AlexanderChad/STM32H743VI_Countdown/Core/Src/main.c

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
/* Includes ------------------------------------------------------------------*/
#include "main.h"

/* USER CODE BEGIN Includes */
#include <stdio.h>
#include <string.h>
#include <time.h>
/* USER CODE END Includes */

/* USER CODE BEGIN PD */
struct tm EventDate;
struct tm NowTime;
int utc_timezone = 7;

#define FONT0_LENGTH            11
#define FONT0_START_CHAR        48
#define FONT0_CHAR_WIDTH        8
#define FONT0_CHAR_HEIGHT       14
#define FONT0_FONT_TYPE         (FONT_TYPE_MONOSPACED)
#define FONT0_ARRAY_LENGTH      (FONT0_LENGTH * FONT0_CHAR_WIDTH)

const unsigned long  font0[FONT0_ARRAY_LENGTH] =
{

        // Digits / Цифры
    0b00000000000000000000011111111000, 0b00000000000000000001111111111110, 0b00000000000000000011100000000111, 0b00000000000000000011000000000011, 0b00000000000000000011100000000111, 0b00000000000000000001111111111110, 0b00000000000000000000011111111000, 0b00000000000000000000000000000000, // Символ 48  <0>
    0b00000000000000000011000000001100, 0b00000000000000000011000000001110, 0b00000000000000000011000000000111, 0b00000000000000000011111111111111, 0b00000000000000000011111111111111, 0b00000000000000000011111111111111, 0b00000000000000000011000000000000, 0b00000000000000000011000000000000, // Символ 49  <1>
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
#define Rx1Buf_SIZE 100 //размер ожидаемой части для добавления в кольцевой буфер

/* USER CODE END PD */


TIM_HandleTypeDef htim1;
TIM_HandleTypeDef htim2;

UART_HandleTypeDef huart1;
UART_HandleTypeDef huart3;
DMA_HandleTypeDef hdma_usart1_rx;

void SystemClock_Config(void);
static void MX_GPIO_Init(void);
static void MX_TIM1_Init(void);
static void MX_USART3_UART_Init(void);
static void MX_DMA_Init(void);
static void MX_USART1_UART_Init(void);
static void MX_TIM2_Init(void);
/* USER CODE BEGIN 0 */

uint16_t TOnLP = 33;
uint16_t Dl_CLK = 5;

uint8_t RAW_DISPLAY[20][32];
uint8_t ColorMatrix = 0;
const uint8_t ColorMatrix0 = 4;
uint8_t ColorMatrix1 = 7;
int SetColorMatrix = 7;

void delay_clk(uint16_t clk) //create delay function
{
	for (uint16_t j = 0; j < clk; j++)
		asm("NOP");
	//Perform no operation //assembly code
}

void delay_us(uint16_t us) //create delay function
{
	for (uint16_t i = 0; i < us; i++) {
		for (uint16_t j = 0; j < 480; j++)
			asm("NOP");
		//Perform no operation //assembly code
	}
}

void SaveSettings() {
	int bp[8] = { utc_timezone, EventDate.tm_sec, EventDate.tm_min,
			EventDate.tm_hour, EventDate.tm_mday, EventDate.tm_mon,
			EventDate.tm_year, SetColorMatrix };
	HAL_FLASH_Unlock();
	FLASH_Erase_Sector(FLASH_SECTOR_7, FLASH_BANK_2, VOLTAGE_RANGE_1);
	HAL_FLASH_Program(FLASH_TYPEPROGRAM_FLASHWORD, SETTINGS_ADDRESS, &bp);
	HAL_FLASH_Lock();
}

void RestoreSettings() {
	int RSetting[8] = { 0 };
	memcpy(RSetting, SETTINGS_ADDRESS, 32);
	utc_timezone = RSetting[0];
	EventDate.tm_sec = RSetting[1];
	EventDate.tm_min = RSetting[2];
	EventDate.tm_hour = RSetting[3];
	EventDate.tm_mday = RSetting[4];
	EventDate.tm_mon = RSetting[5];
	EventDate.tm_year = RSetting[6];
	SetColorMatrix = RSetting[7];
	if (SetColorMatrix) {
		ColorMatrix1 = SetColorMatrix;
	}
}

void SetPixel(uint8_t Xp, uint8_t Yp, uint8_t N_p, uint16_t ON) {
	uint8_t n_byte = 0;
	uint8_t bit_mask;
	if (Yp >= 8) {
		Yp -= 8;
		n_byte = 16;
	}
	if (Yp < 4) {
		if (Xp < 8) {
			n_byte += (Yp % 4) * 4;
		} else {
			n_byte += 2 + (Yp % 4) * 4;
		}
		bit_mask = 128 >> (Xp % 8);
	} else {
		if (Xp < 8) {
			n_byte += 1 + (Yp % 4) * 4;
		} else {
			n_byte += 3 + (Yp % 4) * 4;
		}
		bit_mask = 1 << (Xp % 8);
	}
	uint8_t SP = RAW_DISPLAY[N_p][n_byte] & bit_mask;
	if (ON) {
		if (!SP) {
			RAW_DISPLAY[N_p][n_byte] |= bit_mask;
		}
	} else {
		if (SP) {
			RAW_DISPLAY[N_p][n_byte] &= ~bit_mask;
		}
	}
}

void SetPixelBigPanel(uint8_t Xp, uint8_t Yp, uint16_t ON) {
	uint8_t N_p_adr = 0;
	switch (Yp / 16) {
	case 0:
		N_p_adr = 4 - (Xp / 16);
		Xp = 79 - Xp;
		Yp = 63 - Yp;
		break;
	case 1:
		N_p_adr = Xp / 16 + 5;
		break;
	case 2:
		N_p_adr = Xp / 16 + 15;
		break;
	case 3:
		N_p_adr = 14 - (Xp / 16);
		Xp = 79 - Xp;
		Yp = 63 - Yp;
		break;
	}
	SetPixel(Xp % 16, Yp % 16, N_p_adr, ON);
}

void WriteChar(uint8_t x_s, uint8_t y_s, uint8_t char_id, uint8_t font) {
	if (font == 0) {
		for (uint8_t x_b = 0; x_b < FONT0_CHAR_WIDTH; x_b++) {
			for (uint8_t y_b = 0; y_b < FONT0_CHAR_HEIGHT; y_b++) {
				SetPixelBigPanel(x_s + x_b, y_s + y_b,
						font0[char_id * FONT0_CHAR_WIDTH + x_b] & (1 << y_b));
			}
		}
	} else {
		for (uint8_t x_b = 0; x_b < FONT1_CHAR_WIDTH; x_b++) {
			for (uint8_t y_b = 0; y_b < FONT1_CHAR_HEIGHT; y_b++) {
				if (font1[char_id * FONT1_CHAR_WIDTH + x_b] & (1 << y_b)) {
					SetPixelBigPanel(x_s + x_b, y_s + y_b, 1);
				} else {
					SetPixelBigPanel(x_s + x_b, y_s + y_b, 0);
				}
			}
		}
	}
}

void clear() {
	for (int i = 0; i < 20; i++) {
		for (int j = 0; j < 32; j++) {
			RAW_DISPLAY[i][j] = 0;
		}
	}
}

void Clk_data(uint8_t n_p, uint8_t x_b, uint8_t y_b, uint8_t bit_mask,
		uint8_t CM1, uint8_t CM2, uint8_t n_line) {
	uint16_t CLK_P;
	if (n_line) {
		CLK_P = CLK1_Pin;
		n_p += 10;
		ColorMatrix = ColorMatrix1;
	} else {
		CLK_P = CLK_Pin;
		ColorMatrix = ColorMatrix0;
	}
	digitalWrite(GPIOD, CLK_P, 0);

	if (RAW_DISPLAY[n_p][x_b / 8 + y_b * 4] & bit_mask) {
		CM1 = ColorMatrix;
	}
	if (RAW_DISPLAY[n_p][x_b / 8 + y_b * 4 + 16] & bit_mask) {
		CM2 = ColorMatrix;
	}
	digitalWrite(GPIOA, R1_Pin, CM1 & 0b100);
	digitalWrite(GPIOA, G1_Pin, CM1 & 0b10);
	digitalWrite(GPIOC, B1_Pin, CM1 & 0b1);
	digitalWrite(GPIOA, R2_Pin, CM2 & 0b100);
	digitalWrite(GPIOC, G2_Pin, CM2 & 0b10);
	digitalWrite(GPIOC, B2_Pin, CM2 & 0b1);
	digitalWrite(GPIOD, CLK_P, 1);
	delay_clk(Dl_CLK);
}

void LoadAndShowBufOnPanel(void) {
	uint8_t bit_mask;
	static uint8_t y_b;
	uint8_t x_b;
	uint8_t n_p;
	uint8_t CM1;
	uint8_t CM2;
	digitalWrite(GPIOD, OE_Pin, 1);
		for (n_p = 0; n_p < 10; n_p++) {
			for (x_b = 0; x_b < 32; x_b++) {
				CM1 = CM2 = 0;
				bit_mask = 1 << (x_b % 8);

				Clk_data(n_p, x_b, y_b, bit_mask, CM1, CM2, 0);
				Clk_data(n_p, x_b, y_b, bit_mask, CM1, CM2, 1);

			}
		}
		digitalWrite(GPIOD, STB_Pin, 1);
		digitalWrite(GPIOD, STB_Pin, 0);

		digitalWrite(GPIOD, A_Pin, (y_b & 0b1) > 0);
		digitalWrite(GPIOC, B_Pin, (y_b & 0b10) > 0);

		digitalWrite(GPIOD, OE_Pin, 0);

		y_b++;
		if (y_b >= 4) {
			y_b = 0;
		}
}

char* S_Parser(char *string) {
	static char *source = NULL;
	char *p, *next_data = 0;
	if (string != NULL) {
		source = string;
	}
	if (source == NULL) {
		return NULL;
	}
	if ((p = strpbrk(source, ",")) != NULL) {
		*p = 0;
		next_data = source;
		source = ++p;
	}
	return next_data;
}
uint64_t EventTimeSec;
uint64_t NowTimeSec;
uint64_t NowTimeSec_new;
char SET_data[SIZE_BF_SET] = { 0 };
const char str_SET_data[4] = "SET";
//формат: SET,+3,170222,120000,0,END\n
//+3 - utc_timezone
//170222 - дата в формате DDMMYY
//120000 - время в формате HHMMSS
//0 - цвет, 0 - перебор цветов, 1-7 - 3х-битный RGB-цвет
void GetSetting() {
	char *pstr = strstr(SET_data, str_SET_data);  //Поиск строки
	char *istr = S_Parser(pstr);  //Парсим значения из SET
	uint8_t i_d_SET = 0;
	int e_mon;
	while (istr != NULL)  // Выделение последующих частей
	{
		switch (i_d_SET) {
		case 1:
			sscanf(istr, "%2d", &utc_timezone);
			break;
		case 2:
			sscanf(istr, "%2d%2d%2d", &EventDate.tm_mday, &e_mon,
					&EventDate.tm_year);
			EventDate.tm_mon = e_mon - 1;
			break;
		case 3:
			sscanf(istr, "%2d%2d%2d", &EventDate.tm_hour, &EventDate.tm_min,
					&EventDate.tm_sec);
			EventDate.tm_year += 100;
			break;
		case 4:
			sscanf(istr, "%1d", &SetColorMatrix);
			if (SetColorMatrix) {
				ColorMatrix1 = SetColorMatrix;
			}
			break;
		}
		istr = S_Parser(NULL);  // Выделение очередной части строки
		i_d_SET++;
	}
	EventTimeSec = mktime(&EventDate);
	SaveSettings();
}

const char strfind[4] = "RMC";
char nmea_data[SIZE_BF] = { 0 };
char Rx1Buf[Rx1Buf_SIZE] = { 0 };
void Get_Date_and_Time() {
	char *pstr = strstr(nmea_data, strfind);  //Поиск строки
	char *istr = S_Parser(pstr);  //Парсим значения из RMC
	uint8_t i_d_nmea = 0;
	while (istr != NULL)  // Выделение последующих частей
	{
		if (i_d_nmea == 1) {
			sscanf(istr, "%2d%2d%2d.", &NowTime.tm_hour, &NowTime.tm_min,
					&NowTime.tm_sec);
		}
		if (i_d_nmea == 9) {
			int n_mon;
			sscanf(istr, "%2d%2d%2d", &NowTime.tm_mday, &n_mon,
					&NowTime.tm_year);
			NowTime.tm_mon = n_mon - 1;
			NowTime.tm_year += 100;
			NowTimeSec_new = mktime(&NowTime) + utc_timezone * 3600;
			return;
		}
		i_d_nmea++;
		istr = S_Parser(NULL);  // Выделение очередной части строки
	}
}

uint16_t oldPos = 0;
uint16_t newPos = 0;
void HAL_UART_RxCpltCallback(UART_HandleTypeDef *huart) {
	if (huart == &huart1) {
		uint16_t Size = Rx1Buf_SIZE;
		oldPos = newPos; // Обновляем последнюю позицию перед копированием новых данных
		/* Если данные слишком большие и они вот-вот превысят размер буфера, мы должны направить их в начало буфера
		 * Это необходимо для поддержания циклического буфера
		 * Старые данные в основном буфере будут перекрываться
		 */
		if (oldPos + Size > SIZE_BF) // Если текущая позиция + новый размер данных больше, чем основной буфер
		{
			uint16_t datatocopy = SIZE_BF - oldPos; // узнаем, сколько места осталось в основном буфере
			memcpy((uint8_t*) nmea_data + oldPos, Rx1Buf, datatocopy); // копируем данные в оставшееся пространство

			oldPos = 0;   // указываем на начало буфера
			memcpy((uint8_t*) nmea_data, (uint8_t*) Rx1Buf + datatocopy,
					(Size - datatocopy));   // копируем оставшиеся данные
			newPos = (Size - datatocopy);   // обновляем позицию
		}
		/* если текущая позиция + новый размер данных меньше, чем основной буфер
		 * мы просто скопируем данные в буфер и обновим позицию
		 */
		else {
			memcpy((uint8_t*) nmea_data + oldPos, Rx1Buf, Size);
			newPos = Size + oldPos;
		}
		HAL_UART_Receive_DMA(&huart1, (uint8_t*) &Rx1Buf, Rx1Buf_SIZE);
	}
	if (huart == &huart3) {
		GetSetting();
	}
}

uint16_t time_err = 0;
void HAL_TIM_PeriodElapsedCallback(TIM_HandleTypeDef *htim) {
	if (htim->Instance == TIM1) //check if the interrupt comes from TIM1
	{
		Get_Date_and_Time();
		NowTimeSec++;
		if (NowTimeSec != NowTimeSec_new) {
			time_err++;
			if (time_err > trig_time_err) {
				NowTimeSec = NowTimeSec_new;
				time_err = 0;
			}
		} else {
			time_err = 0;
		}

		//HAL_UART_Receive_IT(&huart3, (uint8_t*) &SET_data, SIZE_BF_SET - 1);
	} else
	if (htim->Instance == TIM2) {
		LoadAndShowBufOnPanel();
	}
}

void print_two_dig(uint8_t x_start, uint8_t y_start, uint8_t two_dig, uint8_t font) {
	if (font == 0) {
		WriteChar(x_start, y_start, two_dig / 10, font);
		WriteChar(x_start + FONT0_CHAR_WIDTH + 2, y_start, two_dig % 10, font);
	} else {
		WriteChar(x_start, y_start, two_dig / 10, font);
		WriteChar(x_start + FONT1_CHAR_WIDTH + 2, y_start, two_dig % 10, font);
	}
}

void print_three_dig(uint8_t x_start, uint8_t y_start, uint16_t three_dig, uint8_t font) {
	uint8_t dig1 = (uint16_t) (three_dig / 100);
	uint8_t dig2 = (uint16_t) (three_dig % 100 / 10);
	uint8_t dig3 = (uint16_t) (three_dig % 10);
	if (font == 0) {
		if (three_dig < 10) {
			WriteChar(x_start, y_start, 10, font);
			WriteChar(x_start + FONT0_CHAR_WIDTH + 5, y_start, dig3, font);
			WriteChar(x_start + FONT0_CHAR_WIDTH + 18, y_start, 10, font);
		} else {
			WriteChar(x_start, y_start, dig1, font);
			WriteChar(x_start + FONT0_CHAR_WIDTH + 5, y_start, dig2, font);
			WriteChar(x_start + FONT0_CHAR_WIDTH + 18, y_start, dig3, font);
		}
	} else {
		if (three_dig < 10) {
			WriteChar(x_start, y_start, 10, font);
			WriteChar(x_start + FONT1_CHAR_WIDTH + 5, y_start, dig3, font);
			WriteChar(x_start + FONT1_CHAR_WIDTH * 2 + 9, y_start, 10, font);
		} else {
			WriteChar(x_start, y_start, dig1, font);
			WriteChar(x_start + FONT1_CHAR_WIDTH + 5, y_start, dig2, font);
			WriteChar(x_start + FONT1_CHAR_WIDTH * 2 + 9, y_start, dig3, font);
		}
	}
}
/* USER CODE END 0 */

/**
  * @brief  The application entry point.
  * @retval int
  */
int main(void)
{
  /* MCU Configuration--------------------------------------------------------*/

  /* Reset of all peripherals, Initializes the Flash interface and the Systick. */
  HAL_Init();

  /* USER CODE BEGIN Init */

	EventDate.tm_sec = 00; //секунды
	EventDate.tm_min = 00; //минуты
	EventDate.tm_hour = 12; //час
	EventDate.tm_mday = 26; //день
	EventDate.tm_mon = 11; //месяц c нуля
	EventDate.tm_year = 122; //год с 1900 года
	EventDate.tm_isdst = 0; //флаг перехода на летнее время

//  	EventDate.tm_sec = 00; //секунды
//  	EventDate.tm_min = 00; //минуты
//  	EventDate.tm_hour = 12; //час
//  	EventDate.tm_mday = 26; //день
//  	EventDate.tm_mon = 11; //месяц c нуля
//  	EventDate.tm_year = 121; //год с 1900 года
//  	EventDate.tm_isdst = 0; //флаг перехода на летнее время


	uint64_t EventTimer;
	EventTimeSec = mktime(&EventDate);
  /* USER CODE END Init */

  /* Configure the system clock */
  SystemClock_Config();

  /* Initialize all configured peripherals */
  MX_GPIO_Init();
  MX_TIM1_Init();
  MX_USART3_UART_Init();
  MX_DMA_Init();
  MX_USART1_UART_Init();
  MX_TIM2_Init();
  /* USER CODE BEGIN 2 */
	HAL_TIM_Base_Start_IT(&htim1);
	HAL_TIM_Base_Start_IT(&htim2);

	HAL_UART_Receive_DMA(&huart1, (uint8_t*) &Rx1Buf, Rx1Buf_SIZE);

//	HAL_UART_Receive_IT(&huart3, (uint8_t*) &SET_data, SIZE_BF_SET - 1);

	//вкл. выход упр. на панели
	HAL_GPIO_WritePin(GPIOD, VCC0_Pin, GPIO_PIN_SET);
	HAL_GPIO_WritePin(GPIOD, VCC1_Pin, GPIO_PIN_SET);

//	RestoreSettings();
  /* USER CODE END 2 */

  /* Infinite loop */
  /* USER CODE BEGIN WHILE */

	//SetPixel(2, 3, 0, 1);
	/*
	 SetPixelBigPanel(64, 0, 1);
	 SetPixelBigPanel(65, 1, 1);
	 SetPixelBigPanel(66, 2, 1);
	 SetPixelBigPanel(67, 3, 1);
	 SetPixelBigPanel(68, 4, 1);
	 SetPixelBigPanel(69, 5, 1);
	 SetPixelBigPanel(70, 6, 1);
	 SetPixelBigPanel(71, 7, 1);
	 SetPixelBigPanel(72, 8, 1);
	 SetPixelBigPanel(73, 9, 1);*/

	//WriteChar(64, 0, 1);
	uint32_t timer_i = 0;
	uint8_t i_c = 0;
	const uint8_t day_w = 3;
	const uint8_t time_w = 40;
	while (1) {

//		LoadAndShowBufOnPanel();



		if (HAL_UART_GetState(&huart1) != HAL_UART_STATE_BUSY_RX) {
			HAL_UART_Receive_DMA(&huart1, (uint8_t*) &Rx1Buf, Rx1Buf_SIZE);
		}

		timer_i++;
		if (SetColorMatrix == 0) {
			if (timer_i % 300 == 0) {
				if (i_c < 8) {
					ColorMatrix1 = i_c;
				} else {
					i_c = 0;
				}
				i_c++;
			}
		}
		if (timer_i % 10000 == 0) {
			if (HAL_GPIO_ReadPin(ON_GPIO_Port, ON_Pin) == GPIO_PIN_SET) {
				//clear();
				if (EventTimeSec > NowTimeSec && NowTimeSec > 1261440000) {
					EventTimer = EventTimeSec - NowTimeSec;
					print_three_dig(14, day_w, (uint16_t) (EventTimer / 86400), 1);
					print_two_dig(5, time_w, (uint8_t) (EventTimer / 3600 % 24), 0);
					WriteChar(23, time_w, 10, 0);
					print_two_dig(31, time_w, (uint8_t) (EventTimer / 60 % 60), 0);
					WriteChar(49, time_w, 10, 0);
					print_two_dig(57, time_w, (uint8_t) (EventTimer % 60), 0);
				} else {
					//Выводим на экран сообщение что счетчик оттикал
					WriteChar(14, day_w, 10, 1);
					WriteChar(14 + FONT1_CHAR_WIDTH + 5, day_w, 10, 1);
					WriteChar(14 + FONT1_CHAR_WIDTH *2 + 9, day_w, 10, 1);

					WriteChar(05, time_w, 10, 0);
					WriteChar(15, time_w, 10, 0);
					WriteChar(23, time_w, 10, 0);
					WriteChar(31, time_w, 10, 0);
					WriteChar(41, time_w, 10, 0);
					WriteChar(49, time_w, 10, 0);
					WriteChar(57, time_w, 10, 0);
					WriteChar(67, time_w, 10, 0);
				}
			} else {
				clear();
			}
		}

    /* USER CODE END WHILE */

    /* USER CODE BEGIN 3 */
	}
  /* USER CODE END 3 */
}

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
