AlexanderChad/STM32H743VI_Countdown/STM32H743VI_Countdown.ioc

Mcu.UserName=STM32H743VITx
PA10.GPIO_Label=G1
PA10.Signal=GPIO_Output
PA8.GPIO_Label=R2
PA8.Signal=GPIO_Output
PA9.GPIO_Label=R1
PA9.Signal=GPIO_Output
PB10.Signal=USART3_TX
PB14.Signal=USART1_TX
PB15.Signal=USART1_RX
PC12.GPIO_Label=ON
PC12.Signal=GPIO_Input
PC6.GPIO_Label=B
PC6.Signal=GPIO_Output
PC7.GPIO_Label=G2
PC7.Signal=GPIO_Output
PC8.GPIO_Label=B2
PC8.Signal=GPIO_Output
PC9.GPIO_Label=B1
PC9.Signal=GPIO_Output
PD10.GPIO_Label=VCC0
PD10.Signal=GPIO_Output
PD11.GPIO_Label=CLK1
PD11.Signal=GPIO_Output
PD12.GPIO_Label=OE
PD12.Signal=GPIO_Output
PD13.GPIO_Label=CLK
PD13.Signal=GPIO_Output
PD14.GPIO_Label=STB
PD14.Signal=GPIO_Output
PD15.GPIO_Label=A
PD15.Signal=GPIO_Output
PD8.GPIO_Label=VCC1
PD8.Signal=GPIO_Output
PD9.Signal=USART3_RX
