AlexanderChad/STM32H743VI_Countdown/Core/Inc/main.h

#define VCC1_Pin GPIO_PIN_8
#define VCC1_GPIO_Port GPIOD
#define VCC0_Pin GPIO_PIN_10
#define VCC0_GPIO_Port GPIOD
#define CLK1_Pin GPIO_PIN_11
#define CLK1_GPIO_Port GPIOD
#define OE_Pin GPIO_PIN_12
#define OE_GPIO_Port GPIOD
#define CLK_Pin GPIO_PIN_13
#define CLK_GPIO_Port GPIOD
#define STB_Pin GPIO_PIN_14
#define STB_GPIO_Port GPIOD
#define A_Pin GPIO_PIN_15
#define A_GPIO_Port GPIOD
#define B_Pin GPIO_PIN_6
#define B_GPIO_Port GPIOC
#define G2_Pin GPIO_PIN_7
#define G2_GPIO_Port GPIOC
#define B2_Pin GPIO_PIN_8
#define B2_GPIO_Port GPIOC
#define B1_Pin GPIO_PIN_9
#define B1_GPIO_Port GPIOC
#define R2_Pin GPIO_PIN_8
#define R2_GPIO_Port GPIOA
#define R1_Pin GPIO_PIN_9
#define R1_GPIO_Port GPIOA
#define G1_Pin GPIO_PIN_10
#define G1_GPIO_Port GPIOA
#define ON_Pin GPIO_PIN_12
#define ON_GPIO_Port GPIOC
