AlexanderChad/STM32H743VI_Countdown/(commit log)

2021-12-22 обновление
    добавлена поддержка сохранения настроек + выбор режима цвета
2021-12-22 добавлены картинки
2021-12-22 bagfix, 5x2 -> 5x4
    bagfix + добавление двух линий матриц (+1 сверху, +1 снизу). Переписаны функции сохранения/восстановления настроек
2021-12-23 recolor
    убрана возможность смены цвета верхней панели
